s-grundner/LVA-EIC-KV/docs/latex/00_acronyms.tex

%%%%%%%%%%%%%%%%%%%%%%%%%%%%%%%%%%%%%%%%%%%%%%%%%%%%%%%%%%%%%%%%%%%%%%%%%%%%%%%%
%% 
%% List of acronyms (based on the acronyms package)
%% 

% Once defined here, you can use \ac{NFC} / \Ac{NFC} / \acf{NFC} / etc. to reference this acronym
\newpage
\addsec{Acronyms}
\begin{acronym}
	\acro{ASIC}{application specific integrated circuit}
	\acro{CMOS}{Complementary Metal Oxide Semiconductor}
	\acro{DAC}{digital to analog converter}
	\acro{DAW}{digital audio workstation}
	% \acro{FPGA}{Field Programmable Gate Array}
	\acro{FSM}{finite statemachine}
	\acro{HDL}{hardware description language}
	\acro{IC}{Integrated Circuit}
	\acro{GM1}{general MIDI level 1}
	\acro{GM2}{general MIDI level 2}
	\acro{LUT}{lookup table}
	\acro{MIDI}{musical instrument digital interface}
	\acro{MSB}{most significant bit}
	\acro{PCB}{printed circuit board}
	\acro{PDK}{process development kit}
	\acro{PWM}{pulse width modulation}
	\acro{UART}{universal asynchronous reciever transmitter}
	\acro{USB}{universal serial bus}
	\acro{SPN}{scientific pitch notation}
	\acro{12ET}{twelve tone equal temperament}
	\acro{I2S}{inter-integrated sound}
\end{acronym}

%% 
%%%%%%%%%%%%%%%%%%%%%%%%%%%%%%%%%%%%%%%%%%%%%%%%%%%%%%%%%%%%%%%%%%%%%%%%%%%%%%%%
