s-grundner/LVA-EIC-KV/docs/latex/main-report.tex

% !TeX program = lualatex
% !TeX encoding = UTF-8
% !TeX spellcheck = en_US
% !BIB program = biber
%% 
%%%%%%%%%%%%%%%%%%%%%%%%%%%%%%%%%%%%%%%%%%%%%%%%%%%%%%%%%%%%%%%%%%%%%%%%%%%%%%%%

%%%%%%%%%%%%%%%%%%%%%%%%%%%%%%%%%%%%%%%%%%%%%%%%%%%%%%%%%%%%%%%%%%%%%%%%%%%%%%%%
%% 
%%            JJJJ   K                         K   UUUU         UUUU  
%%            JJJJ   KKKK                   KKKK   UUUU         UUUU  
%%            JJJJ   KKKKKK               KKKKKK   UUUU         UUUU  
%%            JJJJ      KKKKKK         KKKKKK      UUUU         UUUU  
%%            JJJJ         KKKKKK   KKKKKK         UUUU         UUUU  
%%            JJJJ            KKKKKKKKK            UUUU         UUUU  
%%    JJ     JJJJJ               KKK               UUUUU       UUUUU  
%%  JJJJJJJJJJJJJ    KKKKKKKKKKKKKKKKKKKKKKKKKKK    UUUUUUUUUUUUUUU   
%%    JJJJJJJJJ      KKKKKKKKKKKKKKKKKKKKKKKKKKK      UUUUUUUUUUU     
%% 
%%             Template created by Michael Roland (2021)
%% 
%%%%%%%%%%%%%%%%%%%%%%%%%%%%%%%%%%%%%%%%%%%%%%%%%%%%%%%%%%%%%%%%%%%%%%%%%%%%%%%%

%%%%%%%%%%%%%%%%%%%%%%%%%%%%%%%%%%%%%%%%%%%%%%%%%%%%%%%%%%%%%%%%%%%%%%%%%%%%%%%%
%% 
\documentclass[
	a4paper,
	oneside,
	11pt,
	english
]{scrartcl}
%% 
%%%%%%%%%%%%%%%%%%%%%%%%%%%%%%%%%%%%%%%%%%%%%%%%%%%%%%%%%%%%%%%%%%%%%%%%%%%%%%%%

%%%%%%%%%%%%%%%%%%%%%%%%%%%%%%%%%%%%%%%%%%%%%%%%%%%%%%%%%%%%%%%%%%%%%%%%%%%%%%%%
%% 
\usepackage[utf8]{inputenc}
%% 
%%%%%%%%%%%%%%%%%%%%%%%%%%%%%%%%%%%%%%%%%%%%%%%%%%%%%%%%%%%%%%%%%%%%%%%%%%%%%%%%

%%%%%%%%%%%%%%%%%%%%%%%%%%%%%%%%%%%%%%%%%%%%%%%%%%%%%%%%%%%%%%%%%%%%%%%%%%%%%%%%
%% 
\usepackage[
	TNF,
	techreport,
	nofancyfonts,
	equalmargins
]{jkureport}
%% 
%%%%%%%%%%%%%%%%%%%%%%%%%%%%%%%%%%%%%%%%%%%%%%%%%%%%%%%%%%%%%%%%%%%%%%%%%%%%%%%%

%%%%%%%%%%%%%%%%%%%%%%%%%%%%%%%%%%%%%%%%%%%%%%%%%%%%%%%%%%%%%%%%%%%%%%%%%%%%%%%%
%% 

\usepackage{amsfonts}
\usepackage{subfigure}
\usepackage{pdfpages}
\usepackage[european, straightvoltages]{circuitikz}
\usepackage{marginnote}
\usepackage{wrapfig}
\usepackage{ragged2e}
\usepackage{caption}
\usepackage{siunitx}
\usepackage{tabularx}
\usepackage{pgfplotstable}
\usepackage{enumitem}
\usepackage{lettrine}
\usepackage{acronym}
\usepackage{longtable}
\usepackage{multirow}
\usepackage{url}
\usepackage{makecell}
\usepackage{wasysym}
\usepackage{typicons}
\usepackage{trfsigns}
\usepackage{euler}
\usepackage{algorithm}
\usepackage[noEnd=false,indLines=false]{algpseudocodex}
\usepackage{bm}

%%
%%%%%%%%%%%%%%%%%%%%%%%%%%%%%%%%%%%%%%%%%%%%%%%%%%%%%%%%%%%%%%%%%%%%%%%%%%%%%%%%
%% Settings

\graphicspath{{images/}}
\setcounter{tocdepth}{3}
\captionsetup{font=small}
\newcolumntype{Y}{>{\centering\arraybackslash}X}
\newcommand{\vecb}[1]{\bm{#1}}
\newcommand{\matb}[1]{\bm{#1}}

%% 
%%%%%%%%%%%%%%%%%%%%%%%%%%%%%%%%%%%%%%%%%%%%%%%%%%%%%%%%%%%%%%%%%%%%%%%%%%%%%%%%

\begin{document}

\lstset{
	language=verilog,
	inputpath=../../src,
	captionpos=t
}

\title{Tiny Tapeout - MIDI Polyphonic Synthesizer}
\subtitle{Technical Report\\%
	\usekomafont{subtitlesmall}%
	\hfill\\%
	KV Integrated Circuits Design - WiSe25\\
	\hfill\\%
}
\author{%
	Simon Grundner \\ k12136610%
	\authornewline%
	\affiliation{Institute for Integrated Circuits and Quantum Computing}%
	\authornewline%
	\authormail{k12136610@students.jku.at}
	\authornewline%
	\authorweb{https://github.com/s-grundner/LVA-EIC-KV}
	\authornewline%
}

\partnerlogo{logos/iic.png}
\setbottommark{Simon Grundner (k12136610)}
\abstract{MIDI Polyphonic Synthesizer on the Tiny Tapeout ASIC}
\maketitle

\tableofcontents
\pagenumbering{roman}

\cleardoubleoddpage
\input{00_abstract}
\input{00_acronyms}

\newpage
\pagenumbering{arabic}

\input{01_introduction}
\input{02_theory}
\input{03_summary}
\input{04_receiver}
\input{05_midi-decoder}
\input{06_synth}
\input{07_enc}
\input{08_test}
% \input{08_ext}

\newpage
\appendix
\section{Submission}

For the submission, the git tag \texttt{Sky25b-Submission}\footnote{\url{https://github.com/s-grundner/LVA-EIC-KV/releases/tag/Sky25b-Submission}} was created, for which all workflows \emph{gds, docs} and \emph{test} passed.

\begin{figure}[h]
	\centering
	
	\caption{Badges of the passing workflows}
\end{figure}

The Datasheet of the IC is publicly available\footnote{\url{https://tinytapeout.github.io/tinytapeout-sky-25b/datasheet.pdf}} and the project can be found on page 228.

\section{Used Software}\label{sec:sw}

\begin{table}[h]
	\caption{List of used software for this report}\label{tab:sw}
	\begin{tabularx}{\textwidth}{
		p{(\linewidth - 4\tabcolsep) * \real{0.16}}
		p{(\linewidth - 4\tabcolsep) * \real{0.1}}
		p{(\linewidth - 4\tabcolsep) * \real{0.175}}
		p{(\linewidth - 4\tabcolsep) * \real{0.515}}@{}
		}
		\toprule
		Name                  & Version         & Description          & Usage                                                                                                   \\ \midrule
		Ableton Live 11 Suite & 11.3.43         & \ac{DAW}             & Spectral analysis for instruments. Experiments for audible perceptions of frequency deviations.         \\
		Surfer                & v0.5.0-2        & Waveform Viewer      & Function and Timing analysis of the Verilog Modules.                                                    \\
		IIC-OSIC Tools        & Release 2025.12 & IC design tools      & Docker container providing the LibreLane Toolchain and PDK among other useful open source applications. \\
		Intel Quartus Prime   & 20.1.1          & FPGA Design Software & Examination of RTL diagrams.                                                                            \\
		\bottomrule
	\end{tabularx}
\end{table}

\section{Wikipedia References}

\begin{itemize}[label=\faWikipediaW]
	\item \href{https://en.wikipedia.org/wiki/MIDI}{MIDI - Wikipedia}
	\item \href{https://en.wikipedia.org/wiki/MIDI_tuning_standard}{MIDI tuning standard - Wikipedia}
	\item \href{https://en.wikipedia.org/wiki/Scientific_pitch_notation}{Scientific pitch notation - Wikipedia}
	\item \href{https://en.wikipedia.org/wiki/12_equal_temperament}{12 equal temperament - Wikipedia}
	\item \href{https://en.wikipedia.org/wiki/A440_(pitch_standard)}{A440 (pitch standard) - Wikipedia}
\end{itemize}

\newpage
\input{literature}

\end{document}
\endinput
