s-grundner/LVA-EIC-KV/docs/latex/03_summary.tex

\newpage
\section{System Overview}

\begin{block}
	\begin{center}
		The source code can be found under the follwing link:\\
		{\tiSocialGithub}\,
		\url{https://github.com/s-grundner/LVA-EIC-KV}
	\end{center}
\end{block}

\subsection{Pinout and Top Level Module}

The project features four voices implemented as individual squarewaves oscillators. The output of each oscillator is routed to the outputpins \texttt{uo[0]}\dots\texttt{uo[3]}. Output \texttt{uo[7]} yields a PWM Signal, which encodes the number of actively running oscillators. This output may be used to control the gain of external circuitry, when mixing the oscillator outputs together. The project has one input \texttt{ui[3]}, to which the \acs{MIDI} signal has to be supplied to. This pin is also connected to the \acs{UART}-TX output of the RP2040 microcrontroller, which is populated on the TinyTapeout test \acs{PCB}. The RP2040 may be used to emulate a \acs{MIDI} controller, or to interface the instrument via \acs{USB}. \autoref{fig:pinout} summarises the in- and outputs of the ASIC.

\begin{figure}[h]
	\centering
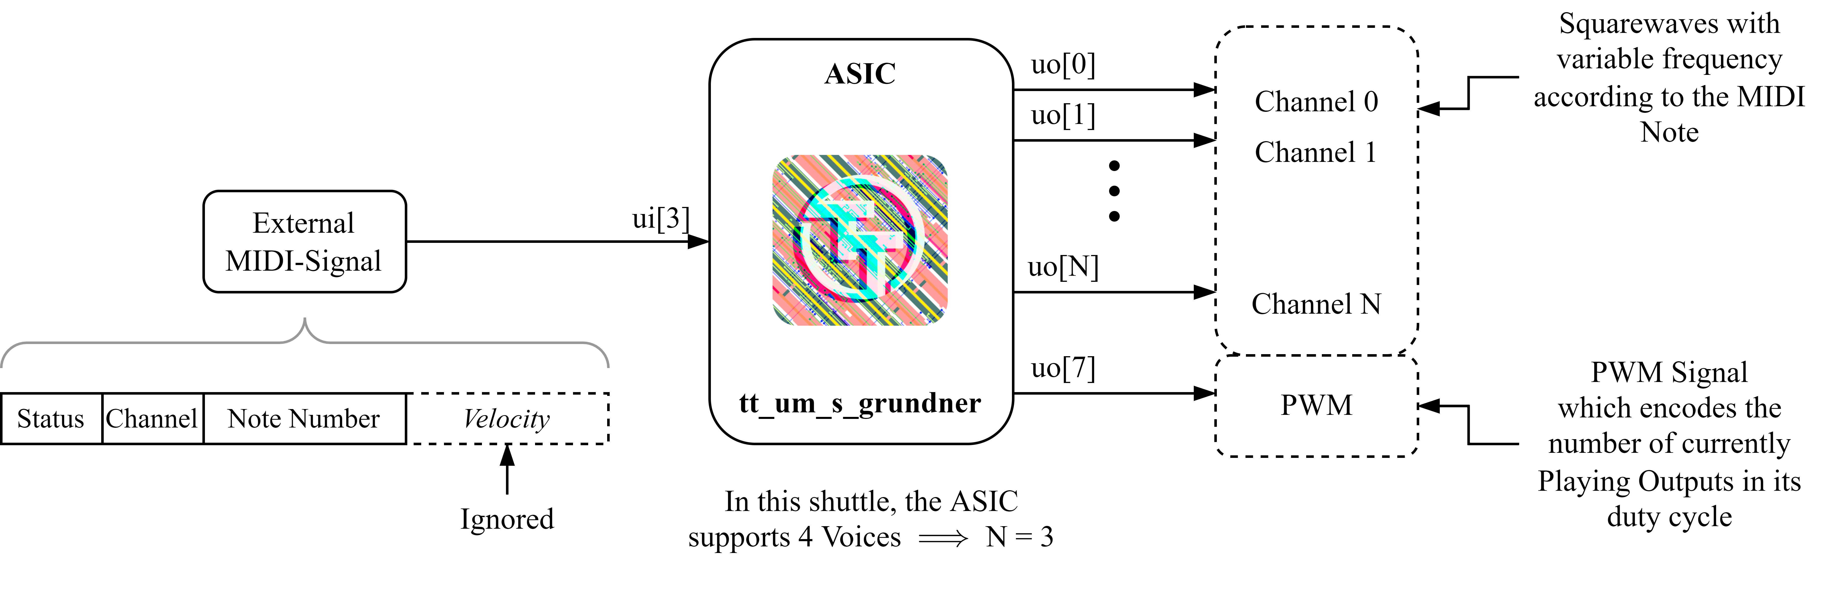
[picture p26: docs/latex/images/bsb-abstract.png]
	
	\caption{Input and output visualisation and description}\label{fig:pinout}
\end{figure}

\subsection{Block Diagram}

An abstract overview of the project implementation can be seen in \autoref{fig:blockdiagram}. The block-titles outside of each block repesent the Verilog module name, coherent with the code-repository.

\begin{figure}[h]
	\centering
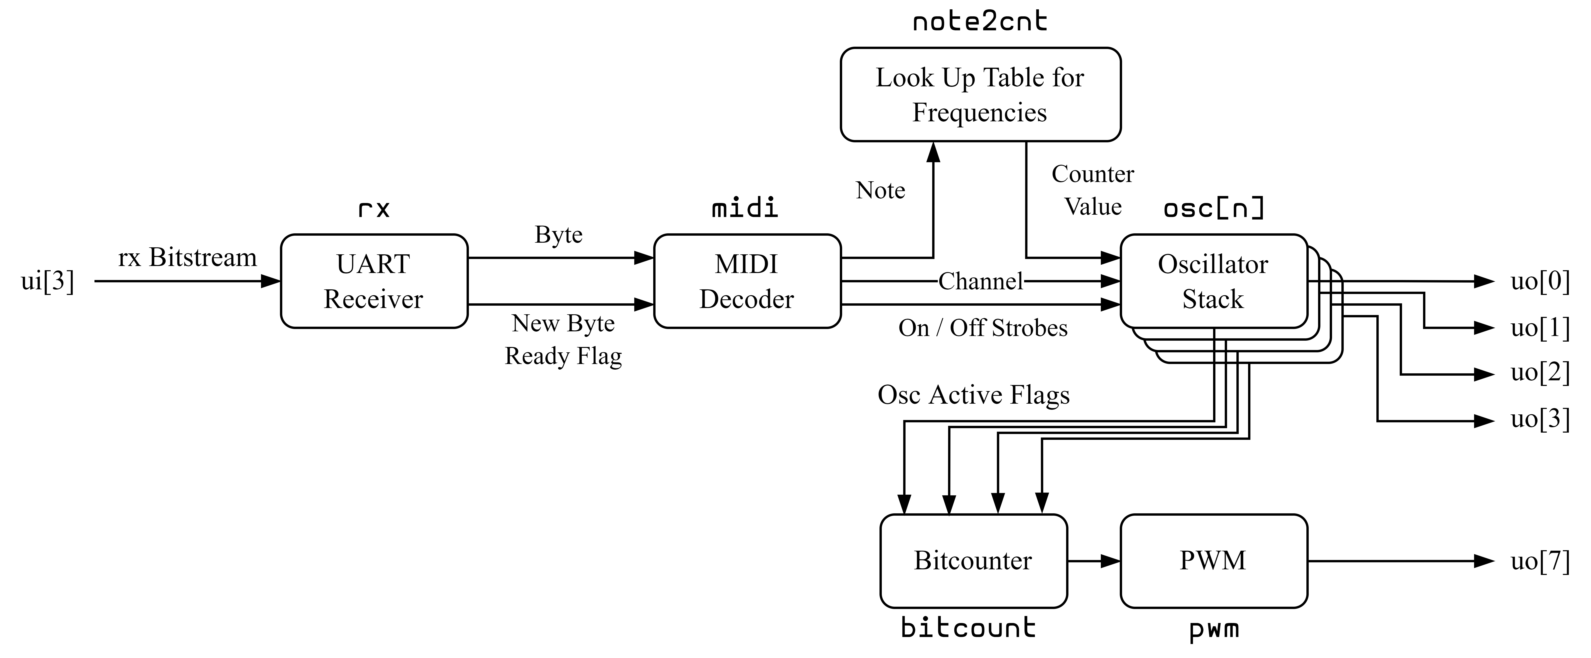
[picture p27: docs/latex/images/bsb-detailed.png]
	
	\caption{Abstract Blockdiagram of the Synthesizer (\texttt{synth} module)}\label{fig:blockdiagram}
\end{figure}

The signal flow starts at the input, where the \acs{MIDI} messages are received via \acs{UART}. The bits of the input stream are collected into bytes, which are then fed into a \acs{MIDI} decoder. The \acs{MIDI} decoder extracts the note- and channel number and if an on or off command is received.

The note number indexes a \ac{LUT}, which returns a counterbase for the corresponding frequency. Each oscillator in the stack is listening on its own \acs{MIDI}-channel. The note-on/note-off commands only affect the oscillator listening on this channel. Upon recieving a note on command, the counterbase value at the input of an oscillator is latched and a counter starts counting repeatedly in this time-base. The output of the oscillator is then toggled after the counter period elapses, which generates the squarewave output.

\subsection{Layout}

To demonstrate the density of the layout, an image of the generated GDS is shown in \autoref{fig:layout}.

\begin{figure}[htbp]
	\centering
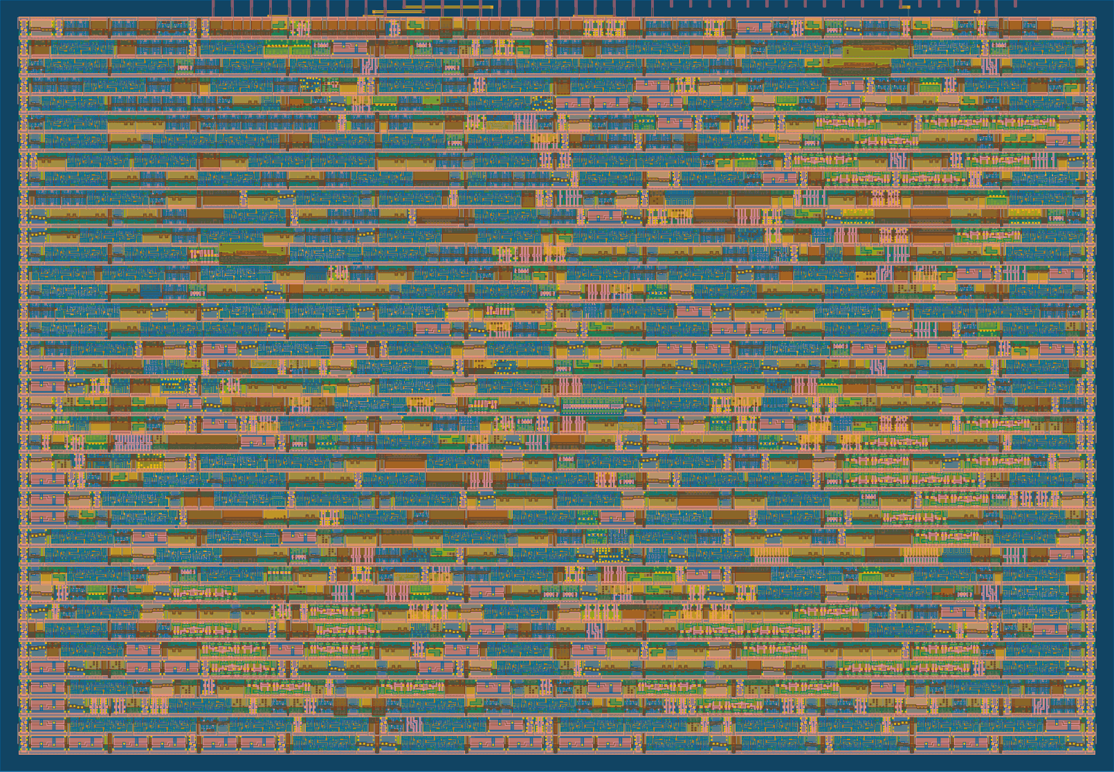
[picture p28: docs/latex/images/layout.png]
	
	\caption{Layout of the Tile}\label{fig:layout}
\end{figure}

The routing statistics generated by the TinyTapeout pipeline are listed in \autoref{tab:routing}. Especially a space utilisation of \SI{74.275}{\percent} shows, that space-optimization was crucial. Per default, the maximum density is set to \SI{60}{\percent}, which had to be adjusted to fit more features. The documentation of the TinyTapeout project stated, that a density of up to \SI{80}{\percent} worked in previous shuttles without issues. The layout as it is shown in \autoref{fig:layout} is comprised of logic cells which are predefined by the \acs{PDK}. Which logic cells are generated from the Verilog code can be seen in \autoref{tab:cells}.

\input{tables/gds.tex}

\subsection{Global Settings}

Certain parameters are reused throughout the entire project. These parameters are collected into a \texttt{global.v} file, which is included in every Verilog source file. The defined global variables are listed in \autoref{tab:global.v}. How these parameters are chosen, will be documented throughout the report.

\begin{table}[ht]
	\caption{Content of \texttt{global.v} in a tabular format}\label{tab:global.v}
	\begin{tabularx}{\textwidth}{llX}
		\toprule
		Variable                      & Value                                 & Description                                           \\ \midrule
		\lstinline!F_CLK_HZ!          & \lstinline!3_496_503!                 & Global Clock Speed which has to be supplied to the IC \\
		\lstinline!F_CLK_PERIOD_NS!   & \lstinline!1_000_000_000 / `F_CLK_HZ! &                                                       \\
		\lstinline!F_BAUD!            & \lstinline!31250!                     &                                                       \\
		\lstinline!F_BAUD_PERIOD_NS!  & \lstinline!1_000_000_000 / `F_BAUD!   &                                                       \\
		\lstinline!MIDI_PAYLOAD_BITS! & \lstinline!8!                         &                                                       \\
		\lstinline!MIDI_NOTE_BW!      & \lstinline!7!                         &                                                       \\
		\lstinline!OSC_VOICES!        & \lstinline!4!                         & MAX 7                                                 \\
		\lstinline!OSC_VOICES_BW!     & \lstinline!$clog2(`OSC_VOICES+1)!     &                                                       \\
		\lstinline!OSC_CNT_BW!        & \lstinline!16!                        & Counter bit width                                     \\
		\lstinline!OSC_ROM_BW!        & \lstinline!7!                         & Note ROM bit width                                    \\
		\bottomrule
	\end{tabularx}
\end{table}

\subsection{Modules}

A quick overview and a brief description on the Verilog modules is given in \autoref{tab:verilog-modules}. How the modules are connected can be seen in \autoref{fig:blockdiagram}.

\begin{table}[h!]
	\caption{Overview of Verilog modules}\label{tab:verilog-modules}
	\begin{tabularx}{\textwidth}{
			p{(\linewidth - 4\tabcolsep) * \real{0.3}}
			p{(\linewidth - 4\tabcolsep) * \real{0.7}}
		}
		\toprule
		Module                       & Description                                                                                                                            \\ \midrule
		\lstinline!tt_um_s_grundner! & Tiny Tapeout top level module                                                                                                          \\
		\lstinline!synth!            & Combines reciever, lookup table und oscillator stack                                                                                   \\
		\lstinline!osc!              & generates a squarewave of specified frequency upon receiving a note on command. Disables output for note off commands                  \\
		\lstinline!midi!             & Extracts note on/off commands, channel and note number from incoming bytes.                                                            \\
		\lstinline!rx!               & RX frontend of midi input. 31250 baud, 8 data bits, no parity                                                                          \\
		\lstinline!note2cnt!         & Convert note numbers to counter base via LUT                                                                                           \\
		\lstinline!counter!          & Counts up on each clock cycle                                                                                                          \\
		\lstinline!bitcount!         & Returns the number of high bits in the input vector                                                                                    \\
		\lstinline!pwm!              & PWM output for encoding the number of active Oscillators. The Frequency of the PWM output is: $f = f_{\text{CLK}} / N_{\text{VOICES}}$ \\
		\bottomrule
	\end{tabularx}
\end{table}
