s-grundner/LVA-EIC-KV/docs/latex/acronyms.tex

%%%%%%%%%%%%%%%%%%%%%%%%%%%%%%%%%%%%%%%%%%%%%%%%%%%%%%%%%%%%%%%%%%%%%%%%%%%%%%%%
%% 
%% List of acronyms (based on the acronyms package)
%% 

% Once defined here, you can use \ac{NFC} / \Ac{NFC} / \acf{NFC} / etc. to reference this acronym
\newpage
\section{Acronyms}
\begin{acronym}
    \acro{MIDI}{Musical Instrument Digital Interface}
    \acro{HDL}{Hardware Description Language}
    \acro{ASIC}{Application Specific Integrated Circuit}
    \acro{PDK}{Process Development Kit}
    % \acro{FPGA}{Field Programmable Gate Array}
    % \acro{CMOS}{Complementary Metal Oxide Semiconductor}
\end{acronym}

%% 
%%%%%%%%%%%%%%%%%%%%%%%%%%%%%%%%%%%%%%%%%%%%%%%%%%%%%%%%%%%%%%%%%%%%%%%%%%%%%%%%
