s-grundner/LVA-EIC-KV/docs/latex/images/quartus-toplevel.png

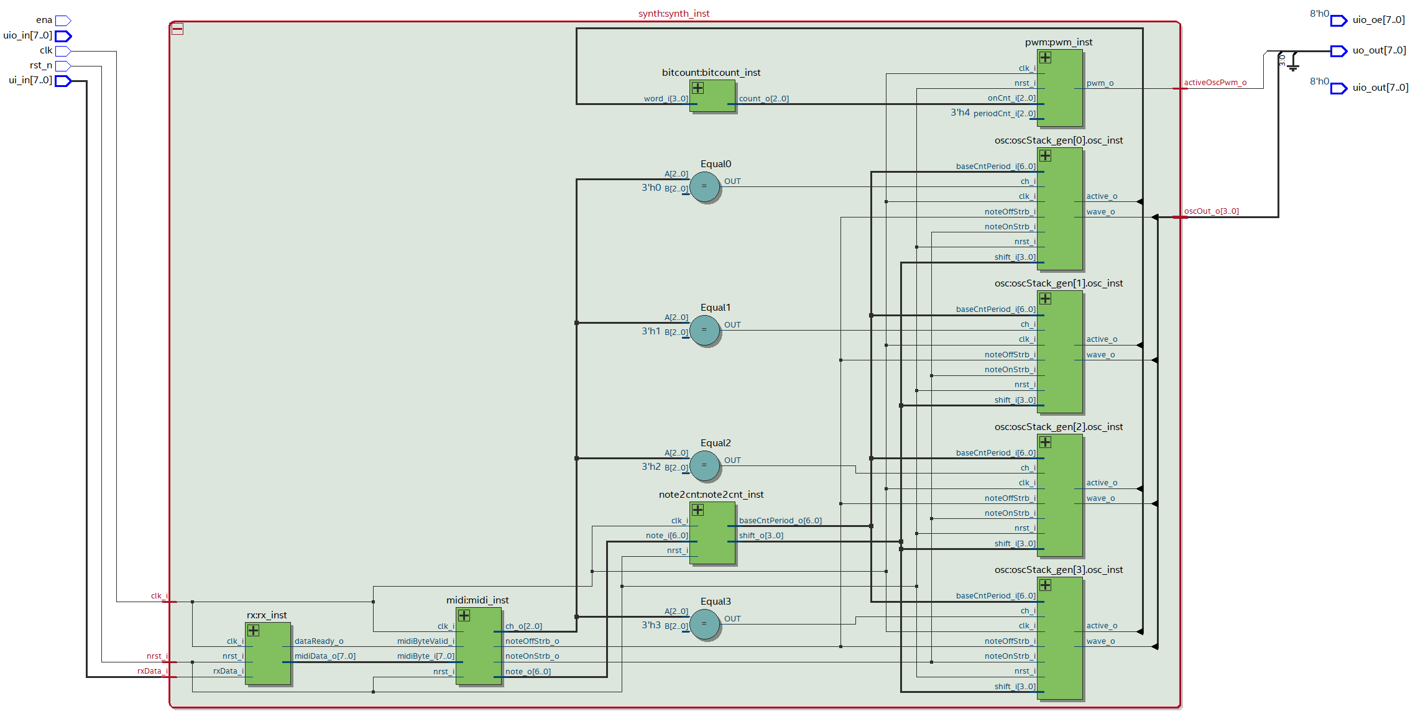
docs/latex/images/quartus-toplevel.png
