s-grundner/LVA-EIC-KV/docs/latex/images/tt-chipmap.png

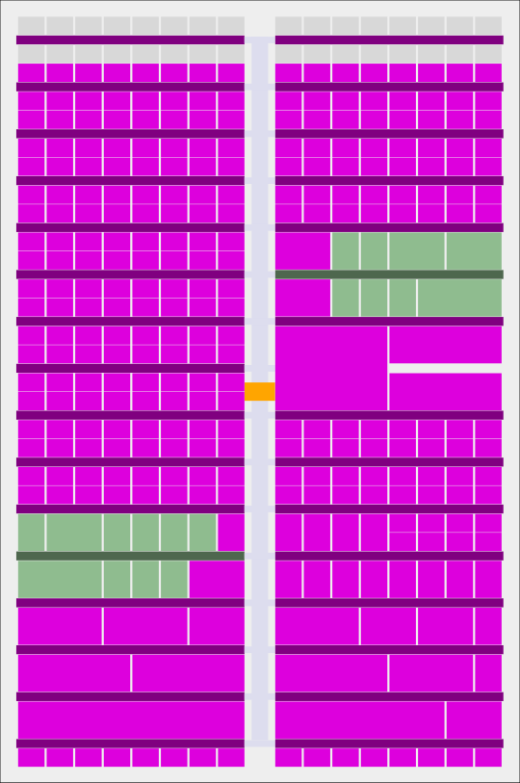
docs/latex/images/tt-chipmap.png
