s-grundner/LVA-EIC-KV/src/global.v

`ifndef __GLOBAL
`define __GLOBAL

`define F_CLK_HZ 3_500_000
`define F_CLK_PERIOD_NS (1_000_000_000 / `F_CLK_HZ)
`define F_BAUD 31250
`define F_BAUD_PERIOD_NS (1_000_000_000 / `F_BAUD)

`define MIDI_PAYLOAD_BITS 8
`define MIDI_NOTE_BW 7

// Oscillator settings
`define OSC_VOICES 4 // MAX 7
`define OSC_VOICES_BW $clog2(`OSC_VOICES+1)
`define OSC_CNT_BW 16 // Counter bit width
`define OSC_ROM_BW 7 // Note ROM bit width

`endif  // __GLOBAL
