s-grundner/LVA-EIC-KV/test/benches/tb_osc.v

/*******************************************************************************
* @file    : tb_osc.v                                                          *
* @author  : @s-grundner                                                       *
* @license : Apache-2.0                                                        *
* @brief   : Testbench for oscillator module.                                  *
*******************************************************************************/

`default_nettype none
`timescale 1ns/1ps

module tb_osc;
	initial begin
		$dumpfile("./waves/tb_osc.vcd");
		$dumpvars(0, tb_osc);
	end

	reg[7:0] note;
	reg clk;
	reg nrst;
	reg noteOnStrb;
	reg noteOffStrb;
	reg[6:0] oscBaseCntPeriod;
	reg ch;
	reg[3:0] shift;

	wire wave;
	wire active;

	osc dut (
		.clk_i(clk),
		.nrst_i(nrst),
		.noteOnStrb_i(noteOnStrb),
		.noteOffStrb_i(noteOffStrb),
		.baseCntPeriod_i(oscBaseCntPeriod),
		.shift_i(shift),
		.ch_i(ch),
		.active_o(active),
		.wave_o(wave)
	);

endmodule
