s-grundner/LVA-EIC-KV/test/benches/tb_rx.v

/*******************************************************************************
* @file    : tb_rx.v (Atomic)                                                  *
* @author  : @s-grundner                                                       *
* @license : Apache-2.0                                                        *
* @brief   : Reciever Module Testbench                                         *
*******************************************************************************/

`default_nettype none
`timescale 1ns/1ps

module tb_rx;

	initial begin
		$dumpfile("./waves/tb_rx.vcd");
		$dumpvars(0, tb_rx);
	end

	// Signals
	reg clk;
	reg nrst;
	reg rxData;
	wire dataReady;
	wire [7:0] payload;

	// DUT instantiation
	rx dut (
		.clk_i(clk),
		.nrst_i(nrst),
		.rxData_i(rxData),
		.dataReady_o(dataReady),
		.midiData_o(payload)
	);
endmodule
