s-grundner/LVA-EIC-KV/test/tb_counter.v

/*******************************************************************************
* @file    : counter_tb.v                                                      *
* @author  : @s-grundner                                                       *
* @license : Apache-2.0                                                        *
* @brief   : Testbench for counter module.                                     *
*******************************************************************************/

`default_nettype none
`timescale 1ns/1ps

module tb_counter;
	initial begin
		$dumpfile("./waves/tb_counter.vcd");
		$dumpvars(0, tb_counter);
	end

	// Parameters
	localparam BW = 4;

	// Signals
	reg clk;
	reg nrst;
	reg nrstSync;
	wire [BW-1:0] count;

	// Clock generation
	initial begin
		clk = 1'b0;
		forever #5 clk = ~clk; // 100MHz clock
	end

	// DUT instantiation
	counter #(
		.BW(BW)
	) dut (
		.clk_i(clk),
		.nrst_i(nrst),
		.nrstSync_i(nrstSync),
		.count_o(count)
	);

	// Test sequence
	initial begin
		// Initialize signals
		nrst = 1'b0;
		nrstSync = 1'b0;

		// Release reset
		#15;
		nrst = 1'b1;
		nrstSync = 1'b1;

		// Run counter
		#105;

		// synchronous reset
		nrstSync = 1'b0;
		#20;
		nrstSync = 1'b1;

		// Run counter
		#100;

		$finish;
	end
endmodule
