s-grundner/LVA-EIC-KV/(commit log)

2025-10-18 feat: ✨ added counter module to top level module
2025-10-18 fix: 🐛 added pinout in info file
2025-10-18 fix: 🐞 wrong top level name
2025-10-18 fix: 🐛 reset signal name
    [counter_tb.v]
2025-10-18 style: 🎨 indentation
2025-10-18 fix: 🐛 bug in rst comparision
    [counter.v]
2025-10-18 ci: 📦 added to testbench and Makefile
2025-10-18 chore: ⚙️ disable wrong test assertion from template project
    [test.py]
2025-10-18 feat: ✨ Added Midi Rx Frontend
2025-10-18 Added Oscillator and PWM Module + submodules
    [counter.v, counter_tb.v, global.v, osc.v, pwm.v, rx.v, synth.v, tb.v]
2025-10-18 docs: 📜 Updated info.yaml
2025-10-18 ci: 📦 updated Makefile
2025-10-18 upd midi wires
2025-10-18 Oscillator Implementation Imported Latex Documents
    [global.v, osc.v, synth.v]
2025-10-18 feat: 🔗 migrate iic-jku tools for local testing
    [pin_order.cfg]
2025-10-18 ci: 📦 Updated Makefile to support multiple targets
2025-10-19 ci: 🦊 Updated Directory structure in GHA; Parametrized Counter TB
2025-10-19 docs: 📜 Update Latex
2025-10-20 ci: 📦 Testbench for note rom lookup
2025-10-20 note2cnt: - replace modulo operation, - update testbench
    [note2cnt.v, osc.v, tb_note2cnt.v, test_note2cnt.py]
2025-10-20 resolved warnings, rename toplevel
    [pin_order.cfg]
2025-10-27 feat: ✨ implemented PWM output which encodes the active Oscillators
    ci: 📦 Added More Testbenches: bitcount used by the PWM encoding.
    perf: 🚀 Oscillators now have their own midi channel to reduce logic.
    The new idea is, that the RP2040 acts as a usb midi interface and
    reroutes midi channels. Direct midi is still supported, but only
    monophonic.
    [bitcount.v, global.v, midi.v, note2cnt.v, osc.v, pwm.v, synth.v, tb_bitcount.v]
2025-10-30 fix: 🚑️ important! Inputpin for RX with RP2040 communication
    [global.v, tt_um_s_grundner.v]
2025-10-31 ci: 📦 More Testbenches:
    - Oscillator Testbench with Output Frequency Measurement and error
    Calculation
    - PWM Test to encode Currently active Oscs in the duty cycle
    - Updated Bit Counter to test counting 0s aswell
    [bitcount.v, osc.v, pwm.v, synth.v, tb_osc.v, tb_pwm.v, test_bitcount.py, test_osc.py]
2025-10-31 fix: 🐛 Fixed Pinout and warnings
    [note2cnt.v, pwm.v, synth.v, tb_bitcount.v, tb_pwm.v, tb_rx.v, test_bitcount.py, test_counter.py]
2025-11-02 fix: 🐞 Fixed early dataready Strobe on RX module
    ci: 🦊 MIDI Testing: Note Correctly read
    debug: 🧪 Started MIDI Testing with following issues:
    - Strobes Not Generating
    - Channel is not set correctly
    [midi.v, rx.v, tb_bitcount.v, tb_counter.v, tb_midi.v, tb_pwm.v, tb_rx.v, test_midi.py]
2025-11-02 fix: 🚑️ Fix Warnings and added Bitwidth of Oscillator Voices as a global parameter
    [global.v, midi.v, synth.v]
2025-11-02 fix: 🐞 Fixed MIDI Module:
    - Corrected Strobe Signals
    - Swapped Cmd and Channel in statusbytes in testbench
    [midi.v, test_midi.py]
2025-11-02 perf: 🚀 Logic of the Oscillator optimized: - Removed redundant registers and if statements - Simplified the synchronous reset logic for the counter - Slight Space save in OpenROAD viewer but not enou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
    [osc.v]
2025-11-06 feat: ✨ Top Level Project Test Successful - Created new tests for the top-level project to ensure all modules integrate correctly. - Set Correct Clock Frequency in config - Simplified Testbench Code 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
    [osc.v, sg_utils.py, tb.v, test.py, test_counter.py, test_midi.py, test_note2cnt.py, test_osc.py]
2025-11-06 test: 🚦 Tested Oscillator more thoroughly - Assert the off state after note off
    [osc.v, test_osc.py]
2025-11-06 fix: 🚑️ Important MIDI Fix - Multiple MIDI Bytes in sequence were not processed correctly. - The VEL state was skipped. Now, after receiving a NOTE, the FSM transitions back to IDLE.
    [midi.v, test_midi.py]
2025-11-06 style: 💅 Minor Test fixups
    [test.py, test_osc.py]
2025-11-06 fix: 🩹 Faults in Tests
    [test_midi.py, test_osc.py]
2025-11-07 test: 🚦 Added another Top Level Testcase (not implemented yet)
2025-11-07 adjusted Target Density before adding another voice. Corrected Clock settings
    [osc.v]
2025-11-07 test: 🚦 completed more Top Level Tests
2025-11-08 docs: 📜 Updated the Markdown Documentation
2025-11-08 perf: 🚀 Reduced redundancy and widths for register transfers - note2cnt: outputs the baseCnt and shift value instead of the full counter value. The rom stores one less bit because it is always 1. Thi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
    [global.v, midi.v, note2cnt.v, osc.v, rx.v, sg_utils.py, synth.v, tb_note2cnt.v]
2025-11-08 Lets add another voice. will probably fail. Observe how the density is affected
    [global.v]
2025-11-08 Adding another voice to the oscillator requires an additional 15% routing density (from 60% to 75%). I am going to leave it at 60% with 3 voices.
    [global.v]
2025-11-10 deploy: 🚀 Final Changes - Send it - Update docs/info.md to clarify MIDI protocol and testing instructions - Added a block diagram - Added a fourth voice to the design
2025-12-23 docs: 📝 Introduction
2025-12-25 ci: 🦊 Disabled Workflow run on push as I am only writing Docs
    docs: 📜 Update MIDI-Chapter
2025-12-29 docs: 📜 Updated Report
    - Section Music Theory expanded with more details on MIDI protocol.
    - Added new references to the bibliography.
    - Included chktexrc for LaTeX linting.
2026-01-16 docs: 📜 Update Receiver and MIDI decoder
2026-01-22 Finished ... Making a Correction Reading
    [note2cnt.v]
